GreyGnome/dice/README.md

# dice
Dice on various devices.

The dice_atmega8 project is available as a full breadboard kit from me. Check it out!

Instructions at https://github.com/GreyGnome/dice/blob/master/dice_atmega8/Build%20Instructions.pdf

Pictures and such at
