GreyGnome/dice/dice_atmega8/Build Instructions.ods

Wire | From | To
Long Black | Negative rail | Negative rail
Long Red | Positive rail | Positive rail
Short black | Negative rail | 30-a
Short black | Negative rail | 30-j
Short black | Negative rail | 20-a
Short black | Negative rail | 19-j
Short red | Positive rail | 19-b
Short green | 12-e | 12-f
Short green | 9-e | 9-f
Short green | 6-e | 6-f
Short green | 2-e | 2-f
Short green | 12-i | 9-i
Short green | 9-h | 8-i
1.5K Ohm Resistor | 2-j | Negative rail
120 Ohm Resistor | 9-j | Negative rail
10cm Jumper Wire | 25-d | 1-h
10cm Jumper Wire | 24-a | 1-a
Blue LED Short |  | 2-d
Blue LED Long |  | 1-e
Red LED Short |  | 2-g
Red LED Long |  | 1-f | Test!
10cm Jumper Wire | 24-g | 11-j
10cm Jumper Wire | 23-h | 8-j
10cm Jumper Wire | 22-i | 5-j
10cm Jumper Wire | 28-g | 7-a
10cm Jumper Wire | 28-a | 11-a
10cm Jumper Wire | 23-a | 8-a
10cm Jumper Wire | 21-a | 5-a
4.7K Ohm Resistor | 19-c | 13-c
Green LED Short | 9-d
Green LED Long | 7-e
Green LED Short | 12-a
Green LED Long | 11-b
Green LED Short | 9-a
Green LED Long | 8-b
Green LED Short | 6-a
Green LED Long | 5-b
Green LED Short | 12-g
Green LED Long | 11-f
Green LED Short | 9-g
Green LED Long | 8-f
Green LED Short | 6-g
Green LED Long | 5-f |  | Test!
10cm Jumper Wire | 28-f | 17-d
10cm Jumper Wire | 28-e | 16-d
Disk Capacitor | Negative rail | Positive rail | Near the short red wire
Switch | 28-b | 30-b
Switch | 29-g | 30-g
Battery wire red | Positive rail |  | Double check!!!
Battery wire black | Negative rail
