GreyGnome/dice/(commit log)

2019-09-14 Initial commit.
    [Build Instructions.ods]
2020-02-24 Nick QA'ed my product. Fixed 4 wiring errors\!
